syvwlch/Printable-Clock-Project/(commit log)

2011-05-07 Unmodified involute gear module from MCAD library
    [involute_gears.scad]
2011-05-07 v9 of my clockwork library
    [clockworkLibrary.scad]
2011-05-07 A little script I use to tune the escapement and escapement wheel
    [Escapement-Animation.scad]
2011-05-07 The core clock-building script, which relies on the clockwork library and on parameters found in a specific clock parameter script to generate a given clock.
    [ClockBuilderScript.scad]
2011-05-07 The current test jig script. The 'clock' it generates is not meant to keep time (it has no hands, and the gear ratios are arbitrary) but rather to give a simple platform on which to test the escapeme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
    [ClockParameters-2G-TestJig.scad]
2011-05-07 The current full clock script, using 8 gears, hour/minute/second hands and the proper gear ratios (60 seconds to a minute, 60 minutes to an hour, 12 hours to a half-day. Not a working, ticking clock 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
    [ClockParameters-8G-12x60.scad]
2011-05-07 A mashup of Emmet's planetary gearbox and my clockwork library.
    [clock_in_a_cage.scad]
2011-05-08 Discovered how you can call libraries in the openSCAD root directory
    [involute_gears.scad]
2011-05-08 Bugfix in spokes() - used spokeWidth instead of spoke_width
    [clockworkLibrary.scad]
2011-05-08 Fix to mcad library path and clockwork library version number
    [clock_in_a_cage.scad]
2011-05-08 Fix to mcad library path and to version number of clockwork library
    [Escapement-Animation.scad]
2011-05-08 Fix to mcad library path and to clockwork library version number
    [ClockBuilderScript.scad]
2011-05-08 Updated to use the club-tooth escapement rather than a ratchet-wheel ideal Graham, which doesn't print that well, with its slender, pointy teeth.
    [ClockBuilderScript.scad]
2011-05-08 A simple test to create a clockwork pinionWheel(). Using it to understand why they gears go bald, sometimes, with the new version of OpenSCAD.
    [Test.scad]
2011-05-08 Level set before dove-tail joinery
    [clock_in_a_cage.scad]
2011-05-08 Dove-tail snap-fit cage added
    [clock_in_a_cage.scad]
2011-05-09 Cleaned up the vertical placement parameters for assembly.
    [clock_in_a_cage.scad]
2011-05-09 Added cap to hold last ring in place, and joined the cage pieces vertically.
    [clock_in_a_cage.scad]
2011-05-09 Made all the rings the same diameter. It looks better.
    [clock_in_a_cage.scad]
2011-05-09 Added cap at the back to hold in the escapement wheel.
    [clock_in_a_cage.scad]
2011-05-09 Added a toggle to show/hide the cage in assembly() view
    [clock_in_a_cage.scad]
2011-05-09 Added ssd for his two (2!) prints of test jig #2!
2011-05-12 TheRuttmeister's print of Test Jig #2 passed all four tests! Looks like we have a working, printable escapement design. Major milestone!
2011-05-12 Added hexagonal counter-sunk holes in the back frame.
    [ClockParameters-2G-TestJig.scad]
2011-05-12 Added wall mounting holes to the back frame (same diameter as the frame bolts).
    [ClockParameters-2G-TestJig.scad]
2011-05-13 v10 -2011 05 08 Modified the drum() module to add holes to attach a string Backwards compatible with no holes if the new arguments are not passed Modified pinionDrum() to make use of this new feature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
    [clockworkLibrary.scad]
2011-05-13 Modified to support the new library feature for adding holes in the drum to attach string.
    [ClockBuilderScript.scad]
2011-05-14 Mitered the countersunk holes, to make them print better.
    [ClockParameters-2G-TestJig.scad]
2011-05-14 Reduced the width of the impulse faces of the escapement pallets, in order to increase drop. This was motivated by the reports from early prints of Test Jig #2 that the escapement was catching on the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
    [ClockBuilderScript.scad]
2011-05-15 Cleaned up some modules that are no longer needed (secondHand, minuteHand and hourHand) because the concept has been generalized.
    [ClockBuilderScript.scad]
2011-05-15 Added snap-fit components for the pendulum.
    [ClockBuilderScript.scad]
2011-05-16 Fixed the negative space version of the pinion wheels (they did not have the right thickness, the spacer term was missing).
    [clockworkLibrary.scad]
2011-05-16 Cleaned up how the countersunk holes were created and corrected some Z thickness issues with the spacer components.
    [ClockParameters-2G-TestJig.scad]
2011-05-16 First commit for the 4 gear version of the clock.
    [ClockParameters-4G-12x60.scad]
2011-05-17 Added countersunk holes for the heads of the bolt securing the back frame to the wall. Round, not hexagonal.
    [ClockParameters-2G-TestJig.scad]
2011-05-17 Widened frame slightly so it clears even the largest possible gear.
    [ClockParameters-2G-TestJig.scad]
2011-05-17 Fixed the position of the frame parts for printing
    [ClockParameters-4G-12x60.scad]
2011-05-17 Fixed position of the frame parts for printing
    [ClockParameters-2G-TestJig.scad]
2011-05-17 First commit for a 6 gear clock with only minute and hour hands
    [ClockParameters-6G-12x60.scad]
2011-05-17 Minor changes to relative dimensions.
    [ClockParameters-6G-12x60.scad]
2011-05-17 Fixed frontframe for sleeve level of pinion #1.
    [ClockParameters-6G-12x60.scad]
2011-05-17 More clean-up!
    [ClockParameters-4G-12x60.scad]
2011-05-17 More clean-up.
    [ClockParameters-2G-TestJig.scad]
2011-05-17 Rebuilt the laid-out-to-print logic for the hands, now that they are fully parametric and there could be, in theory, up to eight of them.
    [ClockBuilderScript.scad]
2011-05-18 Modified to support the ratcheting drum alternative, still backwards compatible.
    [ClockBuilderScript.scad]
2011-05-18 Modified to support ratcheting drum alternative, but still backwards compatible.
    [ClockParameters-6G-12x60.scad]
2011-05-18 Added the first half of the ratcheting drum alternative (the gear and ratchet wheel).
    [clockworkLibrary.scad]
2011-05-18 Ready for ratcheting drum.
    [ClockParameters-2G-TestJig.scad]
2011-05-18 Added the drum part of the ratcheting drum.
    [clockworkLibrary.scad]
2011-05-18 Drum height adjustment to make room for the ratchet.
    [ClockParameters-6G-12x60.scad]
2011-05-18 Tweaks, formatting.
    [clockworkLibrary.scad]
2011-05-18 Moved the definition of the rotation angle which controls where the ratchet arms meet the rim/spokes of the drum to the individual scripts, at least for now.
    [ClockBuilderScript.scad]
2011-05-18 Trying to fix the crashes on the pinion gears. :-(
    [ClockParameters-6G-12x60.scad]
2011-05-18 Fixed the support disk for the pinion in the pinionWheel() module. Radius was calculated as addendum radius MINUS rim width, where to support the whole tooth, it needed to be simply addendum radius.
    [clockworkLibrary.scad]
2011-05-19 Made a long, snap-fit pendulum for the escapement part.
    [ClockBuilderScript.scad]
2011-05-19 Temporary work around for the bald gear OpenSCAD/MCAD bug.
    [ClockParameters-6G-12x60.scad]
2011-05-22 http://www.thingiverse.com/crsdfr asked for an STL of an already assembled clock, suitable for printing as-is in a Selective Laser Sintering printer. This is a rough mod of Test Jig #3 that should be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
    [ClockParameters-6G-12x60-OnePrint.scad]
2012-03-06 Added .DS_Store to .gitignore
    Cloned the repo on a Mac…
2012-03-07 Obsolete after the Clockathons
    No longer supported by the new version of the library, and no backward
    compatibility.
    [ClockParameters-2G-TestJig.scad, ClockParameters-4G-12x60.scad, ClockParameters-6G-12x60.scad, ClockParameters-8G-12x60.scad, Test.scad, clock_in_a_cage.scad]
2012-03-07 Moved parameters out of builder script
    Moved more parameters to the individual clock parameter scripts, for
    flexibility.
    [ClockBuilderScript.scad]
2012-03-07 Fixed escapement rewind
    One of the escapement arms was hitting the back of the teeth, and
    rewinding the clock a little once per beat. Fixed by increasing the
    toothLean.
    [ClockBuilderScript.scad]
2012-03-07 Reduced escapement drop
    Reduced escapement drop (how far the clock moves between falling off
    one escapement pallet and falling onto the other one) by increasing
    faceAngle.
    [ClockBuilderScript.scad]
2012-03-07 Clockathon parameter script
    These are the parameter values arrived at by the end of Clockathon #2
    [ClockParametersClockathon2-v6.scad]
2012-03-07 Deprecated pinionDrum, replaced by pinionWheel
    Instead of using pinionDrum to create a large gear with a drum on top,
    you should now use pinionWheel (the general module) and invoke it with
    small_gear_teeth set to 0, or left default).
    [clockworkLibrary.scad]
2012-03-07 Restored number of spokes in pinionWheel
    Decoupled the number of spokes from the number of teeth on the small
    gear of the pinion wheel.
    [clockworkLibrary.scad]
2012-03-07 Updated the escapement wheel
    Brought it in line with the new, improved pinionWheel module, i.e.
    decoupling the number of spokes from the number of teeth on the pinion
    gear, tweaked the thickness of the spacer ring, etc…
    [clockworkLibrary.scad]
2012-03-07 Tweaks on the ratchet gear/drum pair
    Tweaked the colors and the thicknesses of various parts, spacers rings
    and drums.
    [clockworkLibrary.scad]
2012-03-07 Introduced chirality
    Now that the ratchet can be on either gear one or gear two, it needs to
    exist in clockwise and anti clockwise configurations.
    [clockworkLibrary.scad]
2012-03-07 Ratchet gear now supports a pinion gear
    This is so that a ratchet gear can be placed on gears other than the
    first one (the hour gear). For the hour gear, setting small_gear_teeth
    to zero or leaving it default will result in no pinion gear being
    added, just like in pinionWheel.
    [clockworkLibrary.scad]
2012-03-07 String hole radius parameter deprecated
    [ClockBuilderScript.scad]
2012-03-07 Added recommended values to some comments
    [ClockBuilderScript.scad]
2012-03-07 Updated ratchet1
    To match changes in the library, e.g. chirality, and some formatting.
    [ClockBuilderScript.scad]
2012-03-07 Introduced TrimCircularPitch
    This was added by Ben Fraser, I believe in an effort to make the gears
    mesh better. This would normally have been done with the clearance
    and/or backlash parameters, but I didn't want to mess with success
    during the Clockathon series. I may roll this one back in the future…
    [ClockBuilderScript.scad]
2012-03-07 Gear on shaft or on bearing depending on sleeve
    If a gear has a sleeve extension <> 0, then the gear is resting
    directly on the shaft and its bore radius is pinRadius. If not, it is
    mounted on bearings and its bore radius is bearingRadius.
    [ClockBuilderScript.scad]
2012-03-07 Cosmetic cleanup
    Mostly changes in indentation and tabulation
    [ClockBuilderScript.scad]
2012-03-07 Updated pinion1
    To match the new library, e.g. new ratchetGear and deprecated
    pinionDrum.
    [ClockBuilderScript.scad]
2012-03-07 Added optional ratchet on pinion2
    Now that the library supports having a ratcheting drum on any pinion
    wheel, not just the hour gear.
    [ClockBuilderScript.scad]
2012-03-07 Added ratchet2
    To match the option of a ratchetGear for pinion2
    [ClockBuilderScript.scad]
2012-03-07 Added a spacer to the Escapement
    Keeping it consistent with the other parts
    [ClockBuilderScript.scad]
2012-03-07 Added a spacer to Escapement, part two
    Forgot to include all the calls to the module in the original commit.
    [ClockBuilderScript.scad]
2012-03-07 Fixing the bore radius for the pendulum
    Keeping it consistent with the other parts.
    [ClockBuilderScript.scad]
2012-03-07 Eliminated snap-on pendulum shaft
    Everyone was securing the pendulum another way, anyway.
    [ClockBuilderScript.scad]
2012-03-07 Updating the Ready to Print view
    For Ratchet1 and Ratchet2
    [ClockBuilderScript.scad]
2012-03-07 Tweak the Hands layout in Ready to Print
    [ClockBuilderScript.scad]
2012-03-07 Added the number of spokes to all pinions
    As per change to the Library
    [ClockBuilderScript.scad]
